joaocarlosmalvessi-dotcom/TCC_BENGALA_INTELIGENTE/README.md

# TCC — Bengala Inteligente

Arquivos do projeto de TCC da Bengala Inteligente.
