joaocarlosmalvessi-dotcom/TCC_BENGALA_INTELIGENTE/Impressão3D/Bengala/PeçaBengalaPegada.SLDPRT

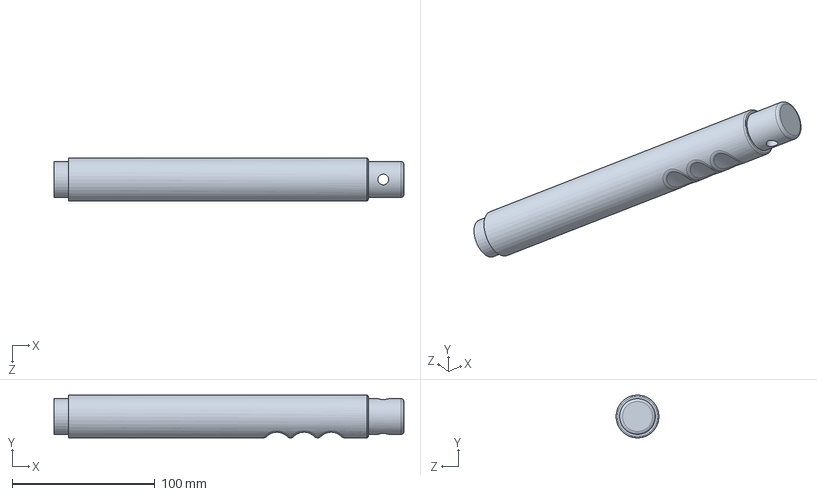
[picture p54: CAD file, 2026-11-04]
Impressão3D/Bengala/PeçaBengalaPegada.SLDPRT
245.0 x 30.0 x 30.0 mm
