joaocarlosmalvessi-dotcom/TCC_BENGALA_INTELIGENTE/Impressão3D/Suportes/CapaPlacaESP-TCC_JoaoCarlos_JoaoRenato.SLDPRT

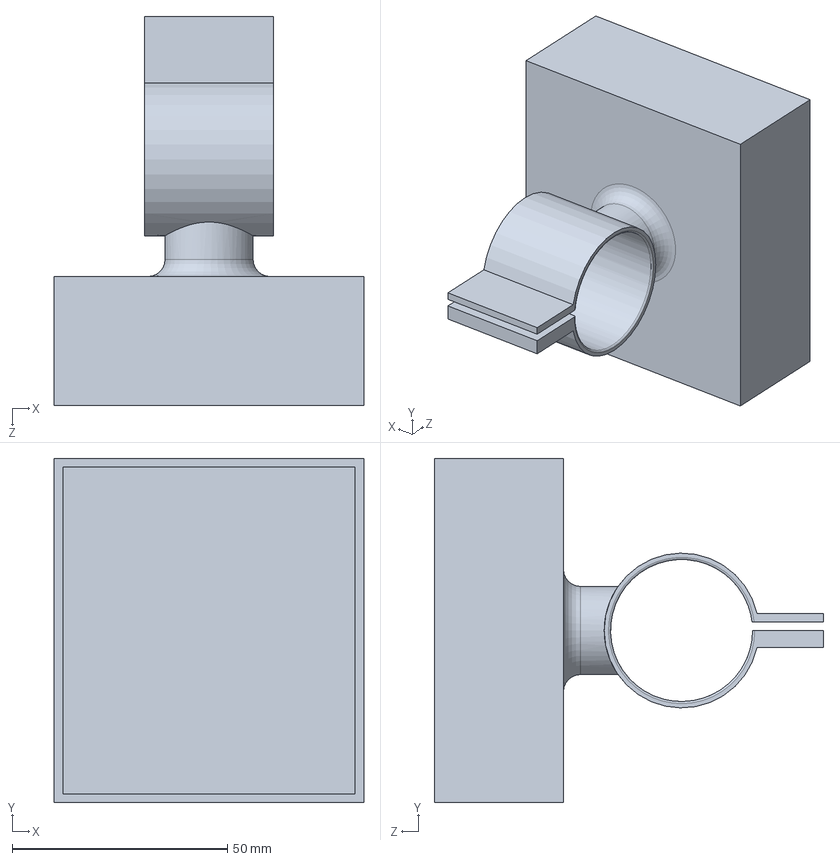
[picture p55: CAD file, 2026-11-04]
Impressão3D/Suportes/CapaPlacaESP-TCC_JoaoCarlos_JoaoRenato.SLDPRT
72.0 x 80.0 x 90.5 mm
