joaocarlosmalvessi-dotcom/TCC_BENGALA_INTELIGENTE/Impressão3D/Bengala/PeçaBengalaPadrão.SLDPRT

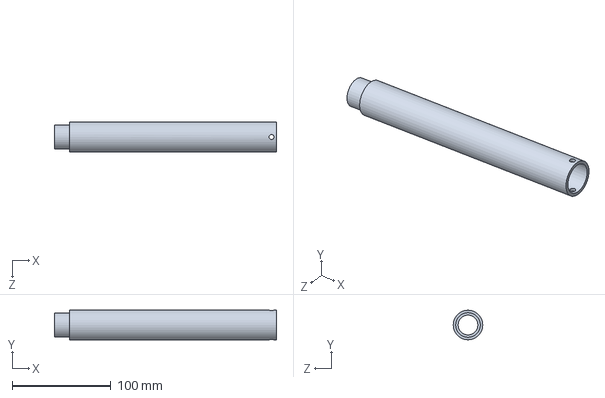
[picture p56: CAD file, 2026-11-04]
Impressão3D/Bengala/PeçaBengalaPadrão.SLDPRT
225.0 x 30.0 x 30.0 mm
