joaocarlosmalvessi-dotcom/TCC_BENGALA_INTELIGENTE/Impressão3D/Suportes/CapaPlacaAlimentacao-TCC_JoaoCarlos_JoaoRenato - Copia.SLDPRT

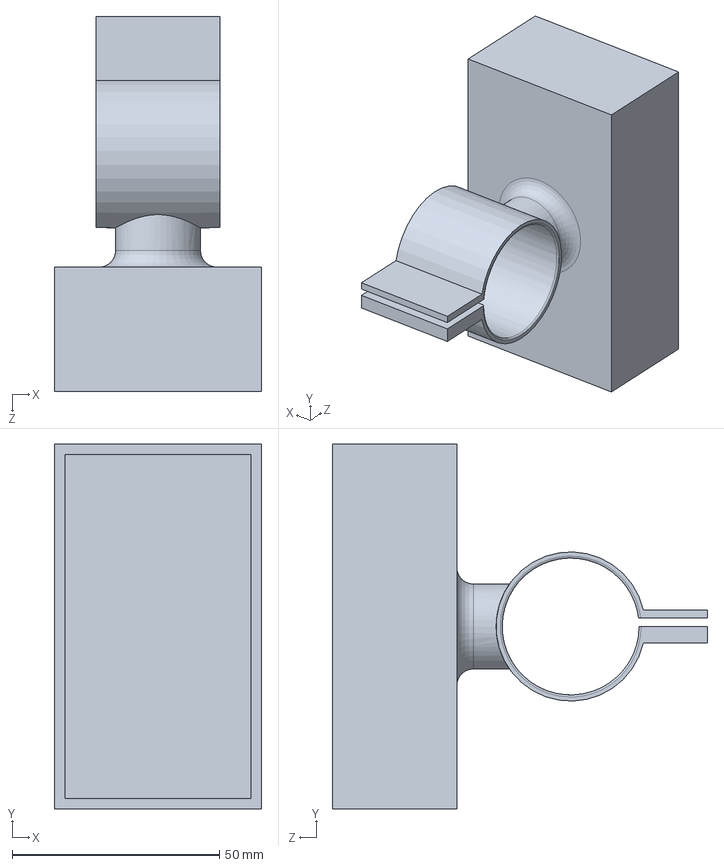
[picture p57: CAD file, 2026-11-04]
Impressão3D/Suportes/CapaPlacaAlimentacao-TCC_JoaoCarlos_JoaoRenato - Copia.SLDPRT
50.0 x 88.0 x 90.5 mm
