joaocarlosmalvessi-dotcom/TCC_BENGALA_INTELIGENTE/Impressão3D/Bengala/PeçaBengalaPrimSensor.SLDPRT

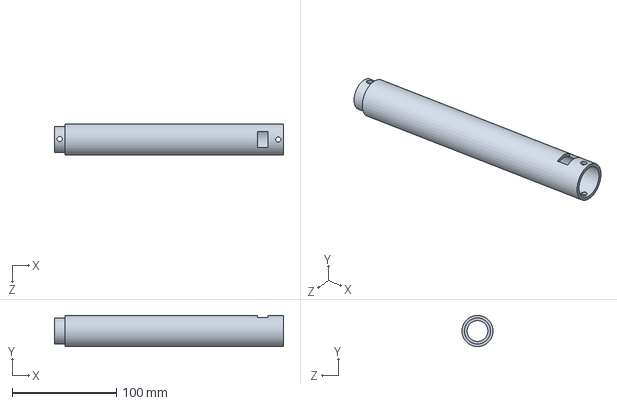
[picture p58: CAD file, 2026-11-04]
Impressão3D/Bengala/PeçaBengalaPrimSensor.SLDPRT
220.0 x 30.0 x 30.0 mm
