joaocarlosmalvessi-dotcom/TCC_BENGALA_INTELIGENTE/(list of files, cad)

Other CAD files:
Impressão3D/Bengala/PeçaBengalaSegundoSensor.SLDPRT
Impressão3D/Bengala/PeçaBengalaPonta.SLDPRT
